amirrezasadeghi0704/saratech/3D designs/0 RAMIN ASL/shield.JPG

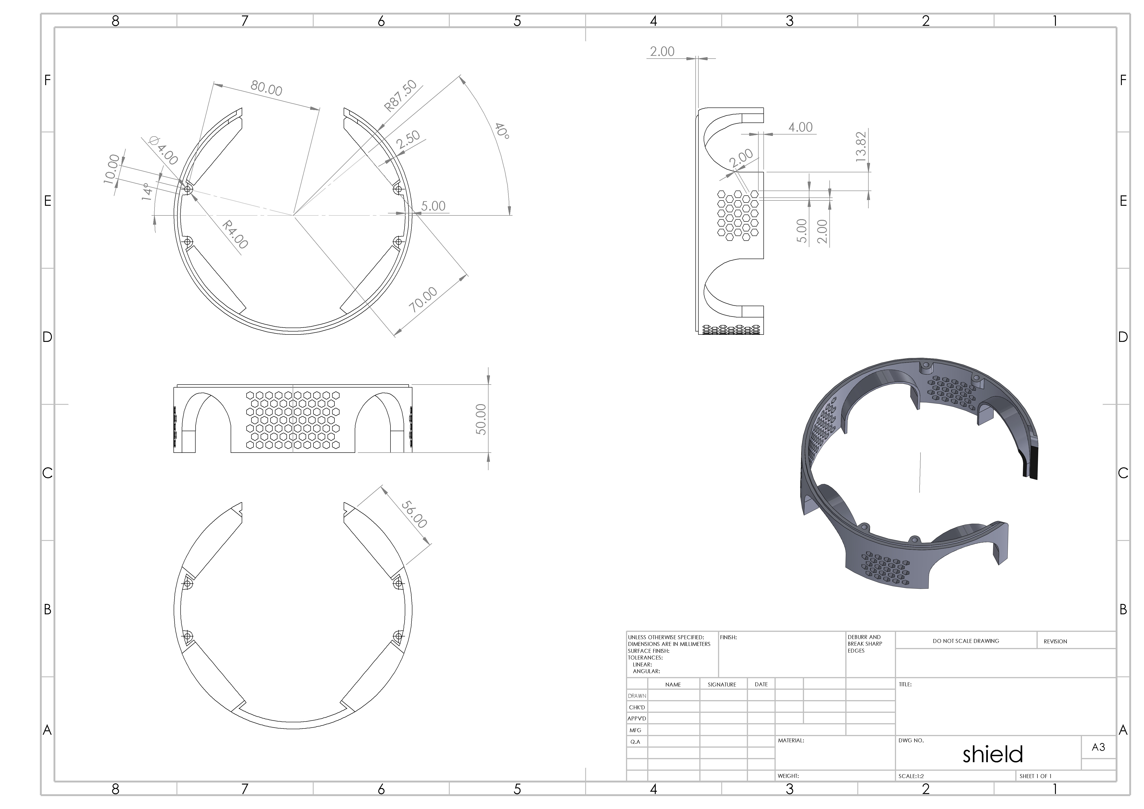
3D designs/0 RAMIN ASL/shield.JPG
