amirrezasadeghi0704/saratech/3D designs/0 RAMIN ASL/spinBase.JPG

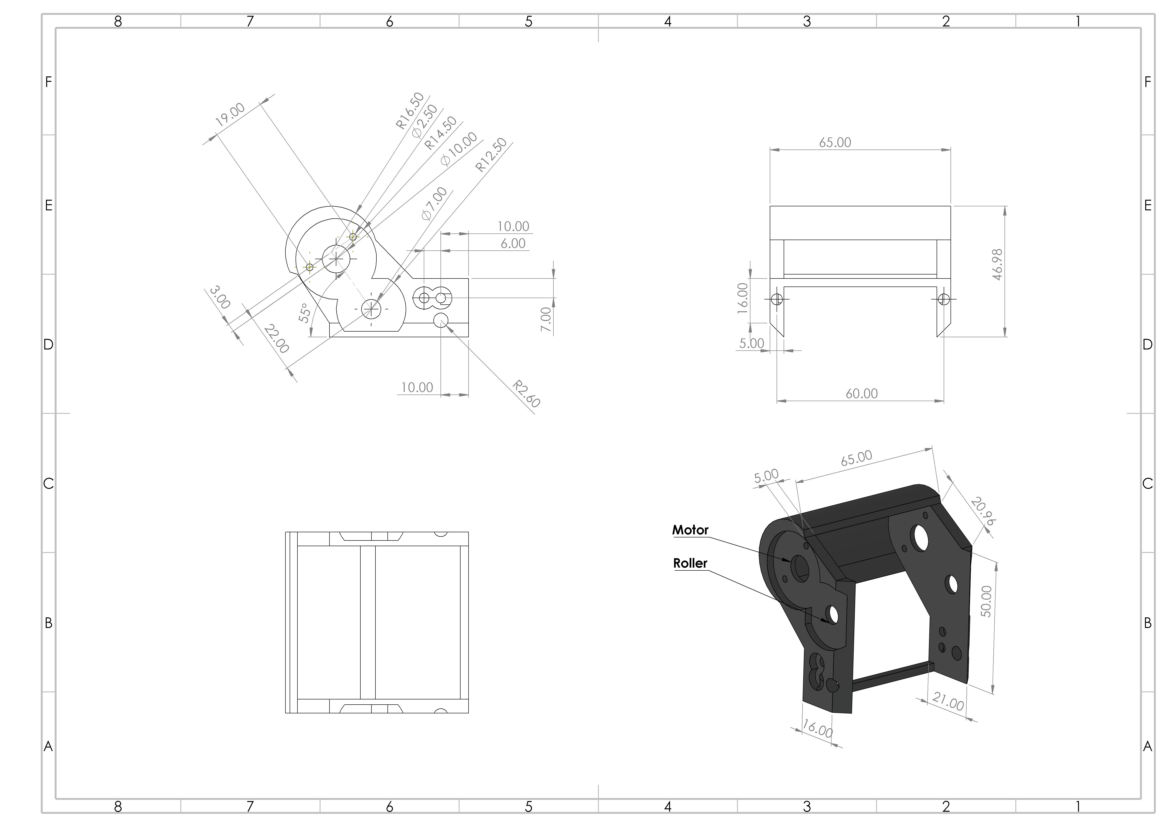
3D designs/0 RAMIN ASL/spinBase.JPG
