amirrezasadeghi0704/saratech/3D designs/0 RAMIN ASL/Assem1.SLDASM

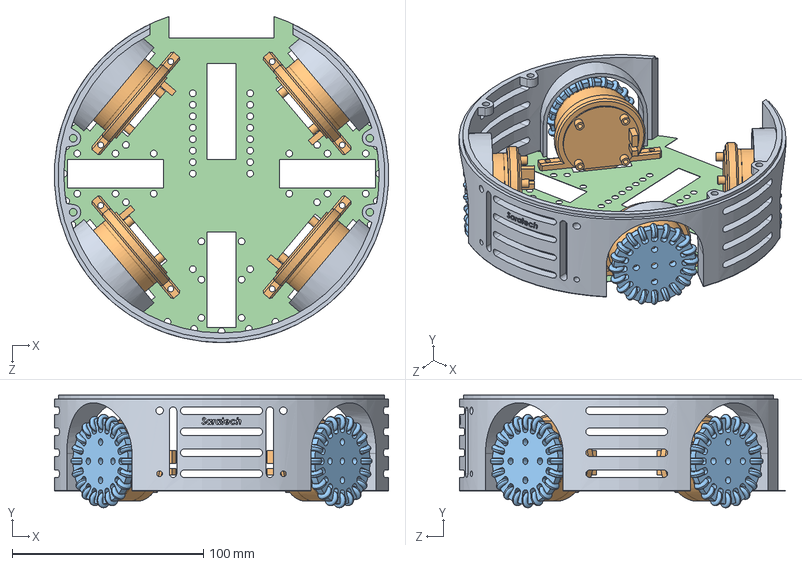
[picture p53: CAD file, 2026-07-27]
3D designs/0 RAMIN ASL/Assem1.SLDASM
174.8 x 58.9 x 170.6 mm
Wheel_GL35 x 4
GL35 Brushless Motor x 4
