amirrezasadeghi0704/saratech/3D designs/0 RAMIN ASL/Part4.SLDPRT

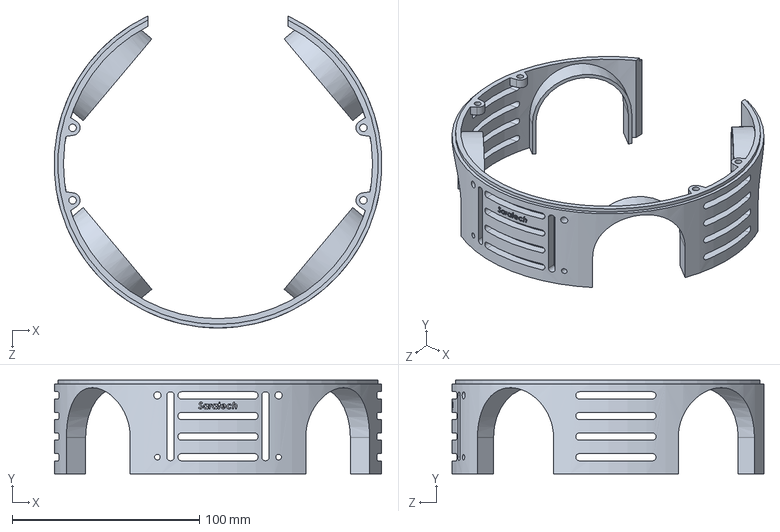
[picture p54: CAD file, 2026-07-27]
3D designs/0 RAMIN ASL/Part4.SLDPRT
174.8 x 50.0 x 166.6 mm
