amirrezasadeghi0704/saratech/3D designs/technocracy/Assem3.STEP

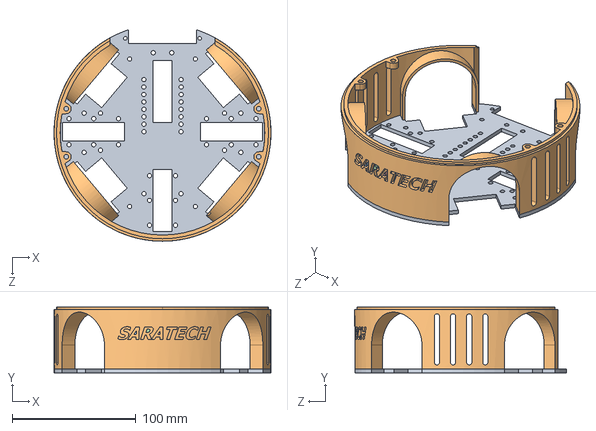
[picture p55: CAD file, 2026-09-02]
3D designs/technocracy/Assem3.STEP
175.0 x 53.0 x 170.6 mm
