amirrezasadeghi0704/saratech/3D designs/0 RAMIN ASL/Wheel_GL35.SLDPRT

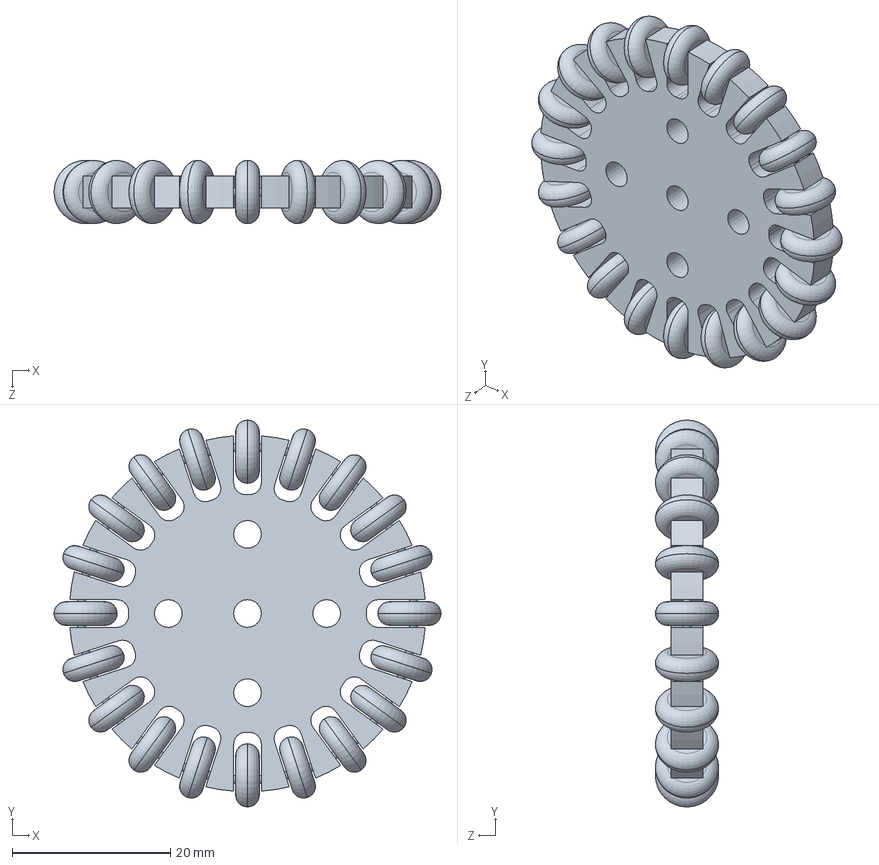
[picture p56: CAD file, 2026-07-27]
3D designs/0 RAMIN ASL/Wheel_GL35.SLDPRT
48.9 x 48.9 x 8.00 mm
