amirrezasadeghi0704/saratech/3D designs/technocracy/Part2.STL

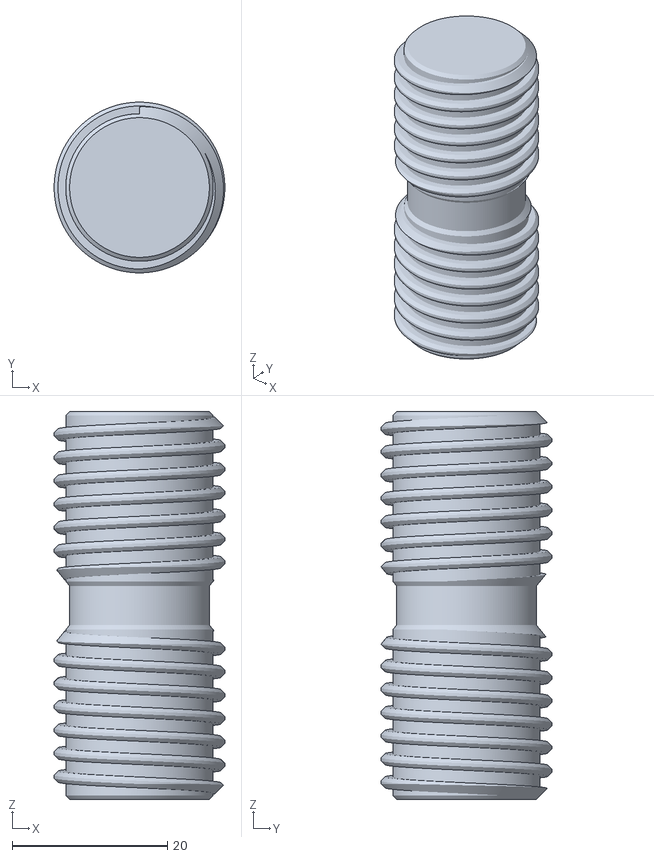
[picture p57: CAD file, 2026-09-02]
3D designs/technocracy/Part2.STL
22.0 x 22.0 x 50.0
