amirrezasadeghi0704/saratech/3D designs/technocracy/Part5 - Copy.STL

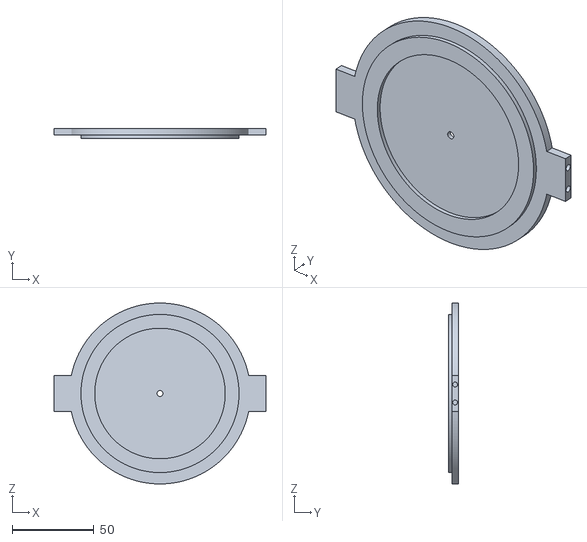
[picture p59: CAD file, 2026-09-02]
3D designs/technocracy/Part5 - Copy.STL
130.0 x 6.00 x 110.9
