amirrezasadeghi0704/saratech/3D designs/technocracy/Part3.STL

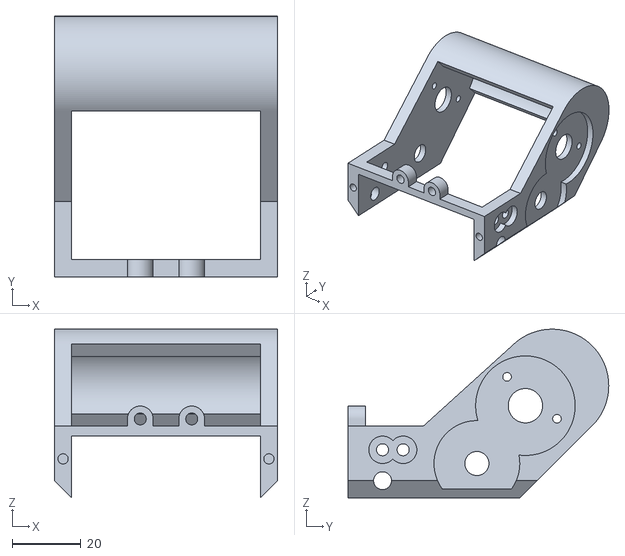
[picture p60: CAD file, 2026-09-02]
3D designs/technocracy/Part3.STL
65.0 x 75.9 x 49.2
