amirrezasadeghi0704/saratech/3D designs/0 RAMIN ASL/raminasl1.SLDPRT

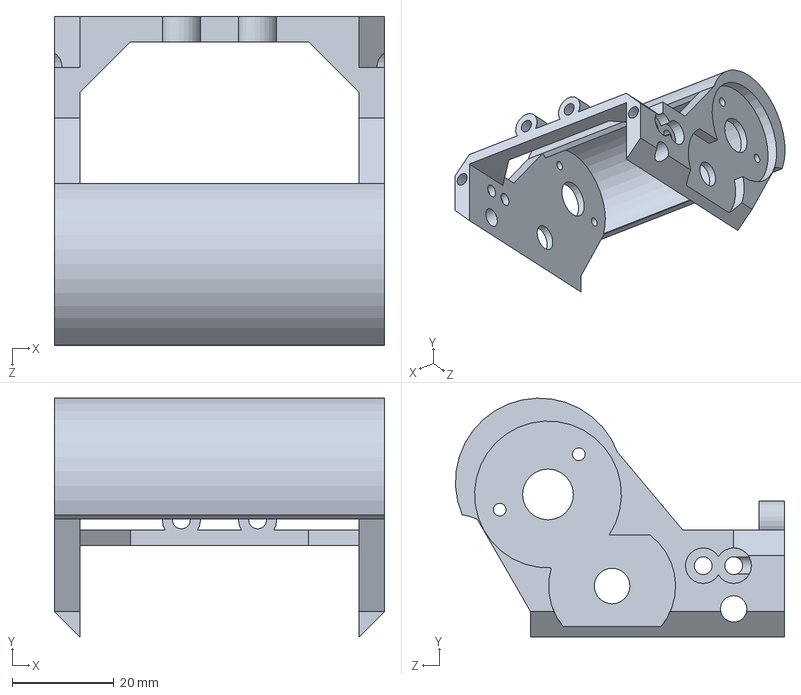
[picture p61: CAD file, 2026-07-27]
3D designs/0 RAMIN ASL/raminasl1.SLDPRT
65.0 x 47.0 x 64.8 mm
