amirrezasadeghi0704/saratech/3D designs/technocracy/Part5_3.STL

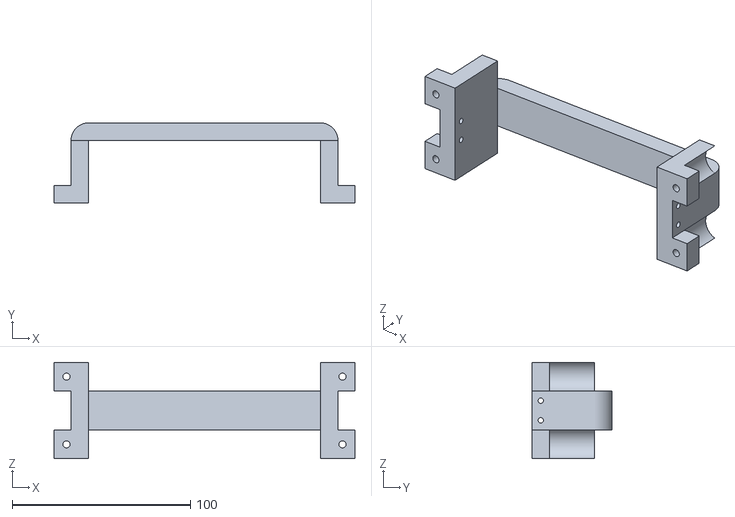
[picture p62: CAD file, 2026-09-02]
3D designs/technocracy/Part5_3.STL
168.7 x 45.0 x 54.0
