amirrezasadeghi0704/saratech/3D designs/0 RAMIN ASL/Part1.SLDPRT

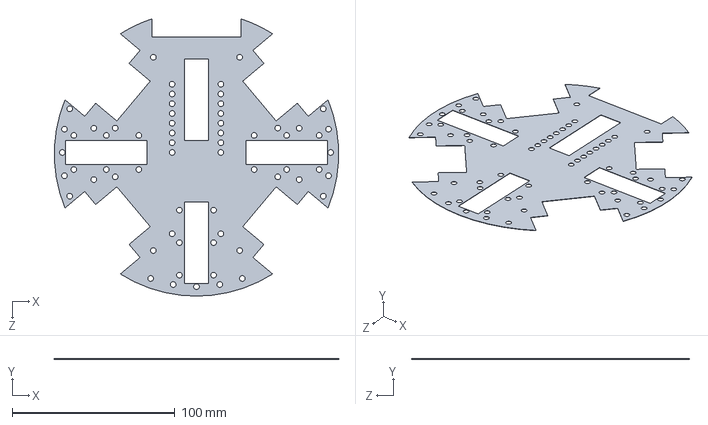
[picture p63: CAD file, 2026-07-27]
3D designs/0 RAMIN ASL/Part1.SLDPRT
174.7 x 0.2 x 170.6 mm
