amirrezasadeghi0704/saratech/3D designs/technocracy/Part6.STL

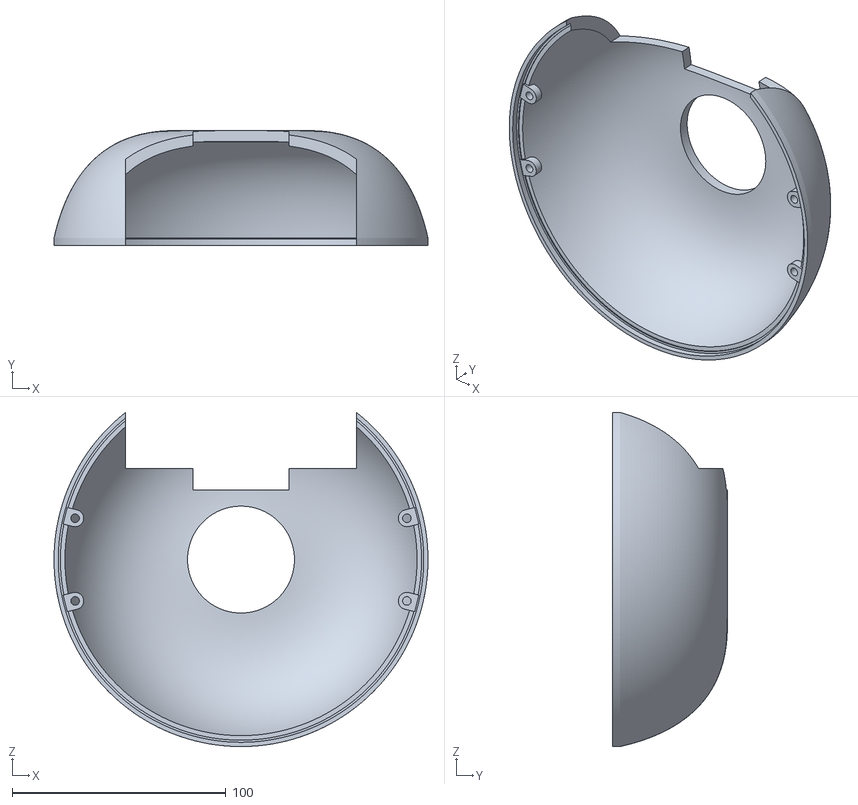
[picture p64: CAD file, 2026-09-02]
3D designs/technocracy/Part6.STL
175.0 x 53.7 x 156.3
