amirrezasadeghi0704/saratech/3D designs/0 RAMIN ASL/GL35 Brushless Motor.SLDPRT

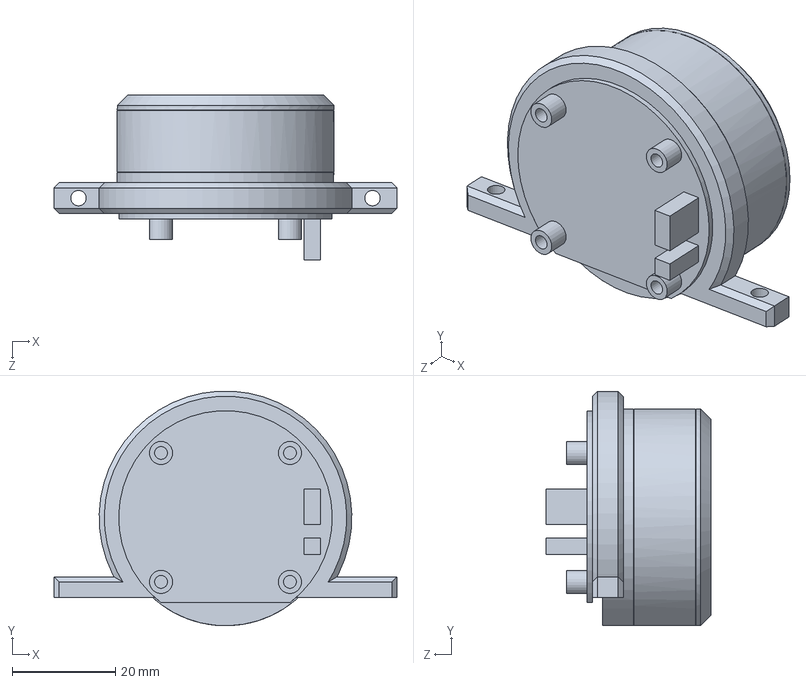
[picture p65: CAD file, 2026-07-27]
3D designs/0 RAMIN ASL/GL35 Brushless Motor.SLDPRT
66.5 x 45.4 x 32.0 mm
