amirrezasadeghi0704/saratech/3D designs/0 RAMIN ASL/chasi_v1.SLDPRT

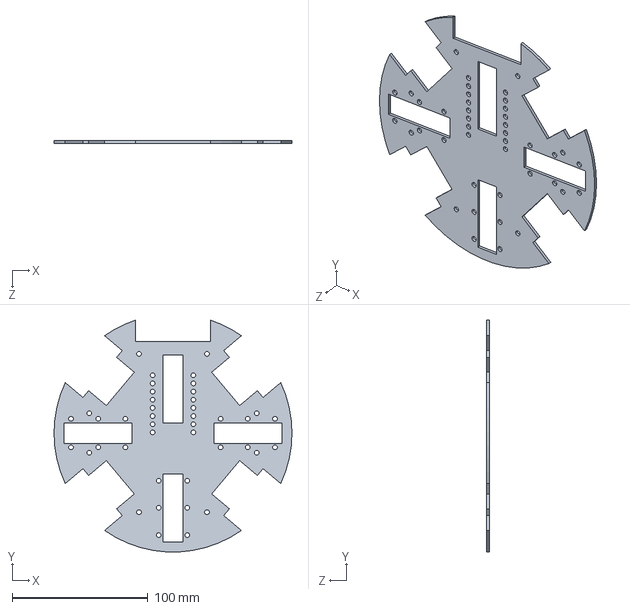
[picture p66: CAD file, 2026-07-27]
3D designs/0 RAMIN ASL/chasi_v1.SLDPRT
175.0 x 170.4 x 2.00 mm
