amirrezasadeghi0704/saratech/3D designs/0 RAMIN ASL/Motor.SLDPRT

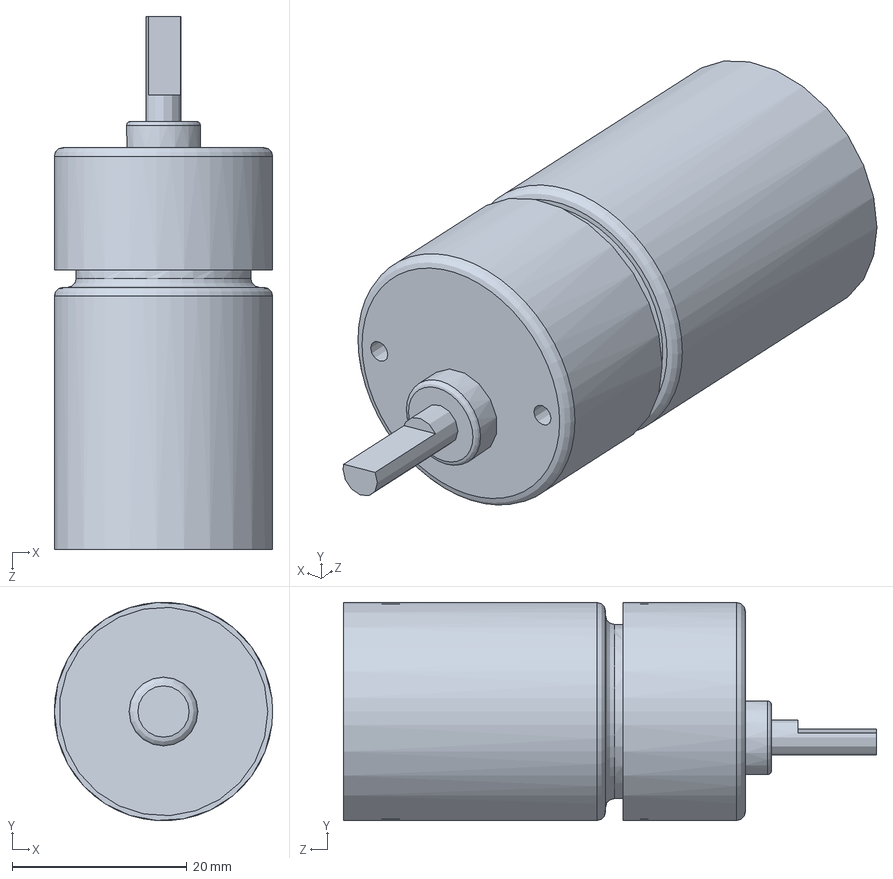
[picture p67: CAD file, 2026-07-27]
3D designs/0 RAMIN ASL/Motor.SLDPRT
25.0 x 25.0 x 61.0 mm
