amirrezasadeghi0704/saratech/3D designs/0 RAMIN ASL/Part2.SLDPRT

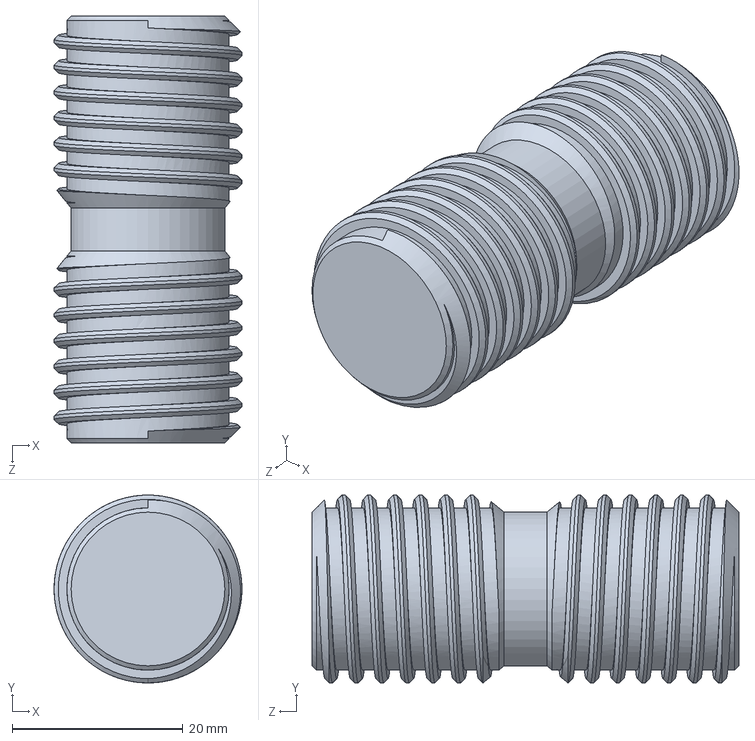
[picture p68: CAD file, 2026-07-27]
3D designs/0 RAMIN ASL/Part2.SLDPRT
22.0 x 22.0 x 50.0 mm
