amirrezasadeghi0704/saratech/(list of files, cad)

Other CAD files:
3D designs/0 RAMIN ASL/spiner.SLDPRT
3D designs/0 RAMIN ASL/Part3.SLDPRT
3D designs/0 RAMIN ASL/raminasl.SLDPRT
