amirrezasadeghi0704/saratech/(list of files, drawings)

Other design files:
RCUP/3D/PCB Designs/SEC/0 RAMIN ASL/line.PcbDoc
RCUP/3D/PCB Designs/SEC/0 RAMIN ASL/motor plate.PcbDoc
RCUP/3D/PCB Designs/SEC/0 RAMIN ASL/PCB1.PcbDoc
RCUP/3D/PCB Designs/SEC/0 RAMIN ASL/stm32 light weight1-22cm-P1.PcbDoc
RCUP/3D/PCB Designs/SEC/0 RAMIN ASL/stm32 light weight1-22cm-P2.PcbDoc
RCUP/3D/PCB Designs/SEC/0 RAMIN ASL/stm32 light weight1-22cm-P3.PcbDoc
RCUP/3D/PCB Designs/SEC/0 RAMIN ASL/stm32 light weight1-22cm-PinEdit.PcbDoc
